natyavidhan/openpurifier/print/basic/07_mains_cradle.stl

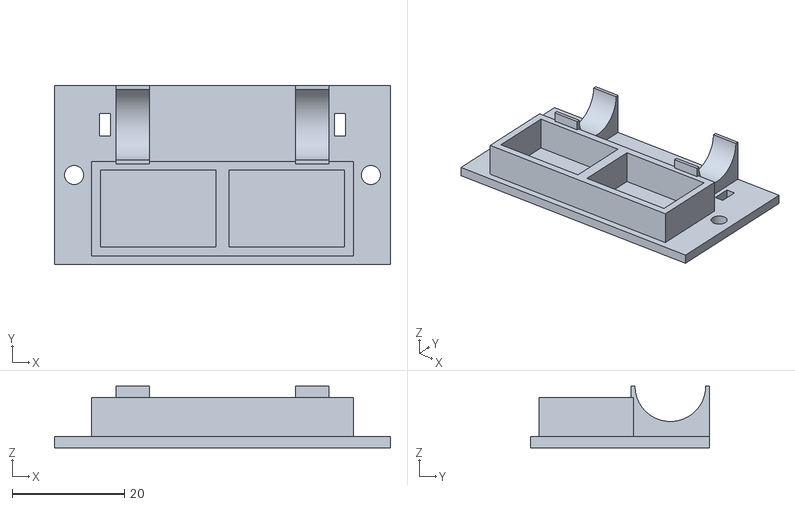
[picture p7: CAD file, 2026-11-10]
print/basic/07_mains_cradle.stl
60.0 x 32.0 x 11.0
