natyavidhan/openpurifier/print/basic/02_shell_upper.stl

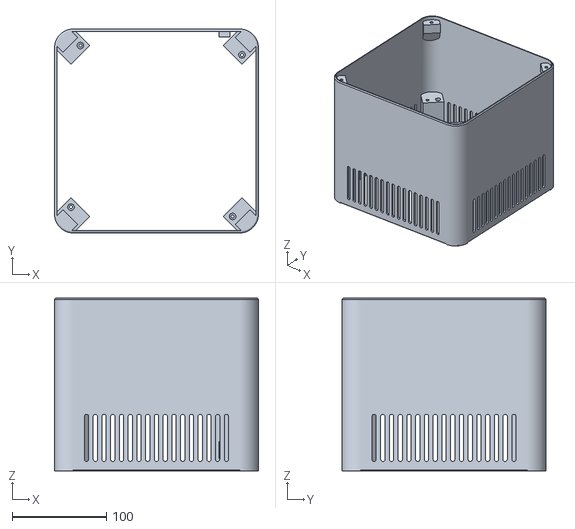
[picture p8: CAD file, 2026-11-10]
print/basic/02_shell_upper.stl
216.0 x 216.0 x 183.0
