natyavidhan/openpurifier/print/smart/06_top_cap.stl

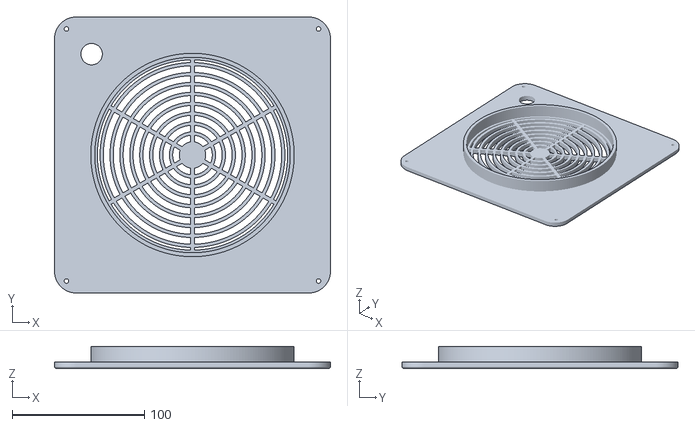
[picture p9: CAD file, 2026-11-10]
print/smart/06_top_cap.stl
209.0 x 209.0 x 17.0
