natyavidhan/openpurifier/print/basic/05_deck_basic.stl

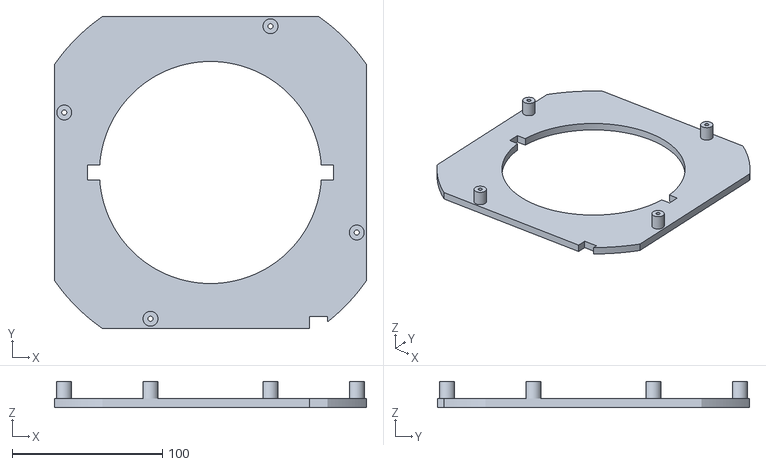
[picture p10: CAD file, 2026-11-10]
print/basic/05_deck_basic.stl
208.0 x 208.0 x 17.5
