natyavidhan/openpurifier/print/smart/08_relay_lid.stl

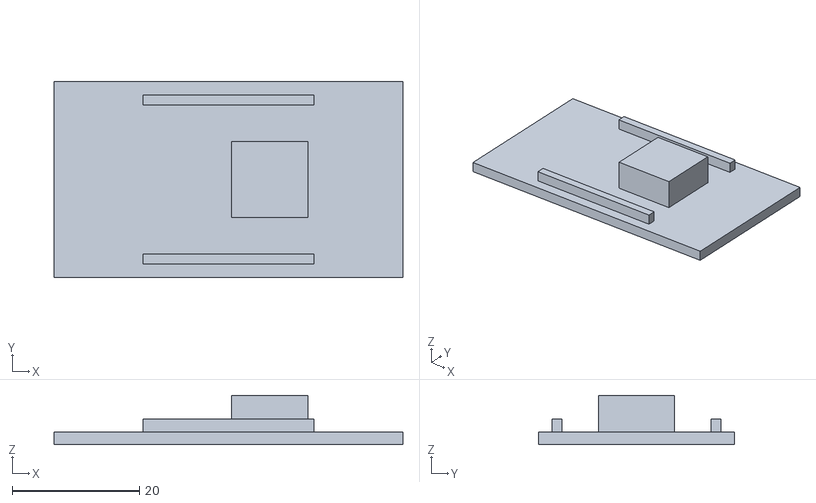
[picture p11: CAD file, 2026-11-10]
print/smart/08_relay_lid.stl
54.8 x 30.8 x 7.70
