natyavidhan/openpurifier/print/basic/03_tray.stl

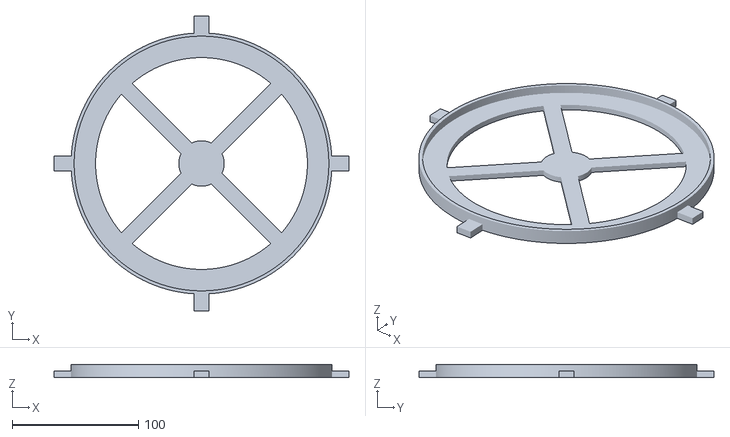
[picture p12: CAD file, 2026-11-10]
print/basic/03_tray.stl
234.0 x 234.0 x 10.0
