natyavidhan/openpurifier/print/smart/10_psu_lid.stl

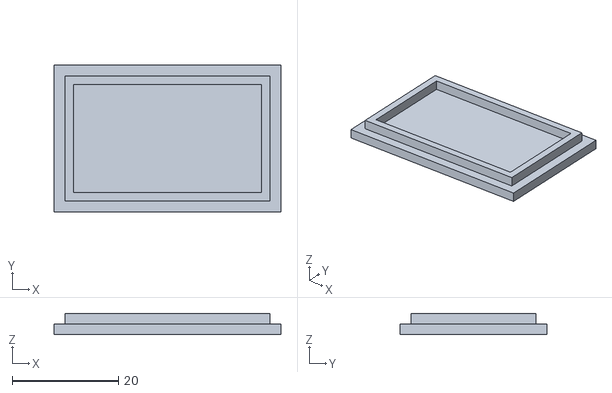
[picture p13: CAD file, 2026-11-10]
print/smart/10_psu_lid.stl
42.8 x 27.8 x 4.00
