natyavidhan/openpurifier/print/smart/07_relay_box.stl

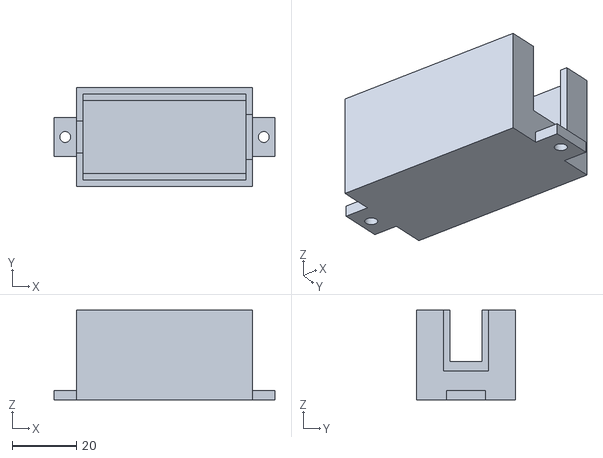
[picture p14: CAD file, 2026-11-10]
print/smart/07_relay_box.stl
68.8 x 30.8 x 28.0
