natyavidhan/openpurifier/print/basic/04_transition_plate.stl

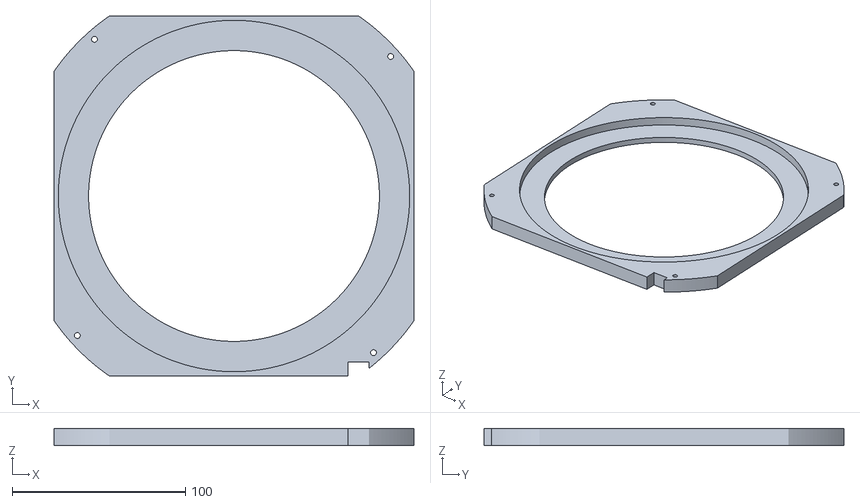
[picture p15: CAD file, 2026-11-10]
print/basic/04_transition_plate.stl
208.0 x 208.0 x 10.0
