natyavidhan/openpurifier/print/basic/01_shell_lower.stl

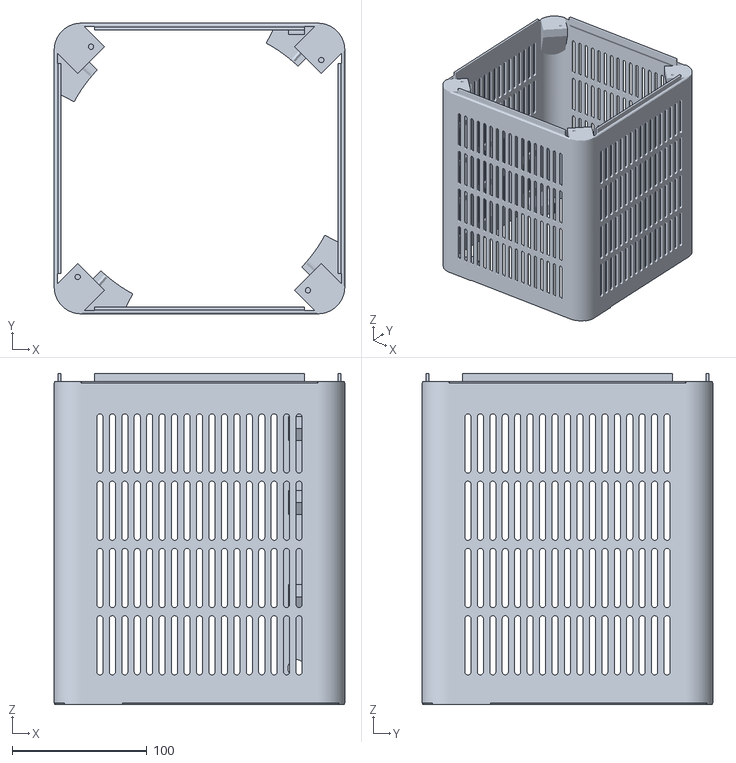
[picture p16: CAD file, 2026-11-10]
print/basic/01_shell_lower.stl
216.0 x 216.0 x 246.0
