natyavidhan/openpurifier/print/smart/11_esp32_holder.stl

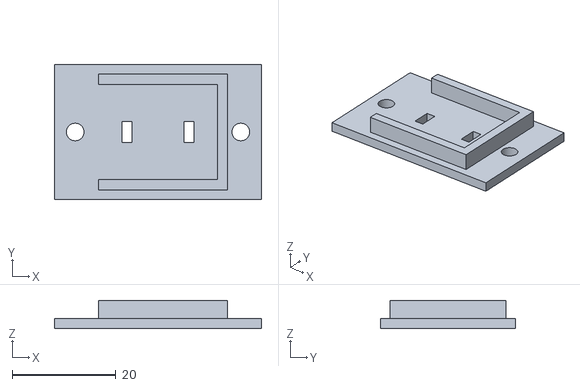
[picture p17: CAD file, 2026-11-10]
print/smart/11_esp32_holder.stl
40.0 x 26.0 x 5.50
