natyavidhan/openpurifier/print/smart/05_deck.stl

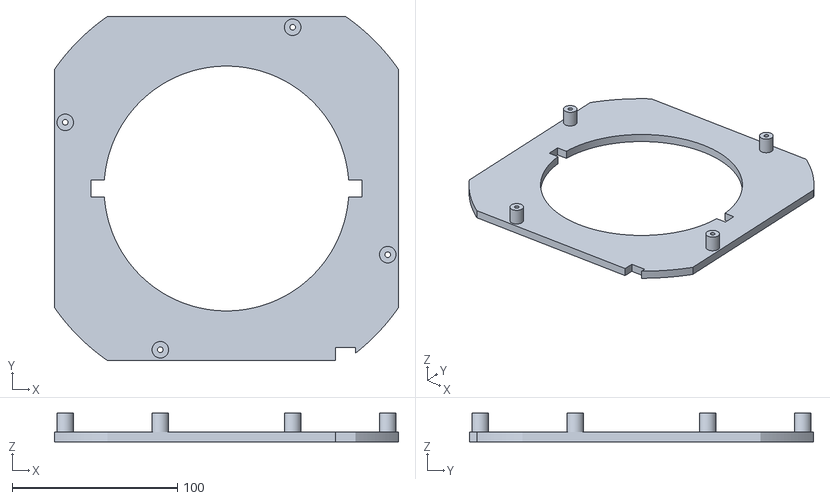
[picture p18: CAD file, 2026-11-10]
print/smart/05_deck.stl
208.0 x 208.0 x 17.5
