natyavidhan/openpurifier/print/smart/09_psu_box.stl

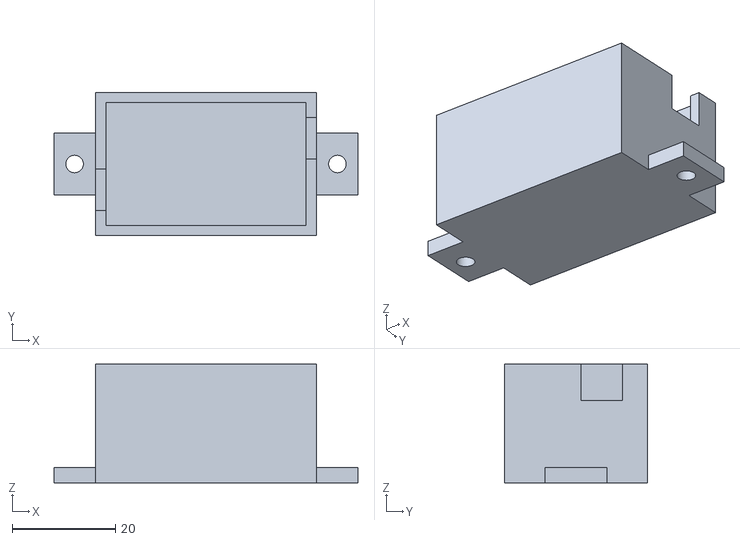
[picture p19: CAD file, 2026-11-10]
print/smart/09_psu_box.stl
59.0 x 27.8 x 23.0
