natyavidhan/openpurifier/(list of files, cad)

Other CAD files:
print/basic/06_top_cap_basic.stl
