natyavidhan/openpurifier/circuit/wiring.html

230 V live (brown) neutral (blue) +5 V GND relay signal button LED ring

From | To | Wire
Plug L (brown) | F1 fuse, then WAGO L bus; from there to HLK AC L and K1 COM | 0.75 mm2
K1 NO | Fan L (brown). K1 NC stays empty | 0.75 mm2
Plug N (blue) | WAGO N bus; from there to HLK AC N and fan N (blue) | 0.75 mm2
HLK +V0 (+5V) | ESP32 5V, K1 DC+, button LED+, C1 + | 24 AWG
HLK -V0 (GND) | ESP32 GND, K1 DC-, button COM, Q1 emitter, C1 -, R1 | 24 AWG
GPIO4 | K1 IN; R1 10 k from IN to GND keeps the relay off while the ESP32 boots | 26 AWG
GPIO3 | Button NO (internal pull-up, pressed = low) | 26 AWG
GPIO5 | R3 1 k to Q1 base; Q1 collector to button LED- | 26 AWG
